cmu-argus-2/Avionics-BatteryBoard/MAX17205 Config/Page 4.png

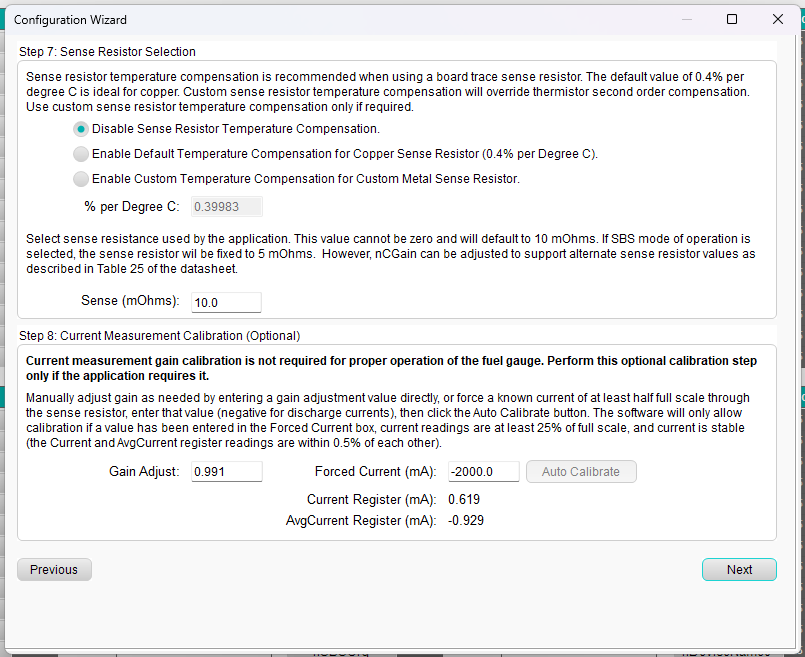
MAX17205 Config/Page 4.png
