cmu-argus-2/Avionics-BatteryBoard/MAX17205 Config/Page 5.png

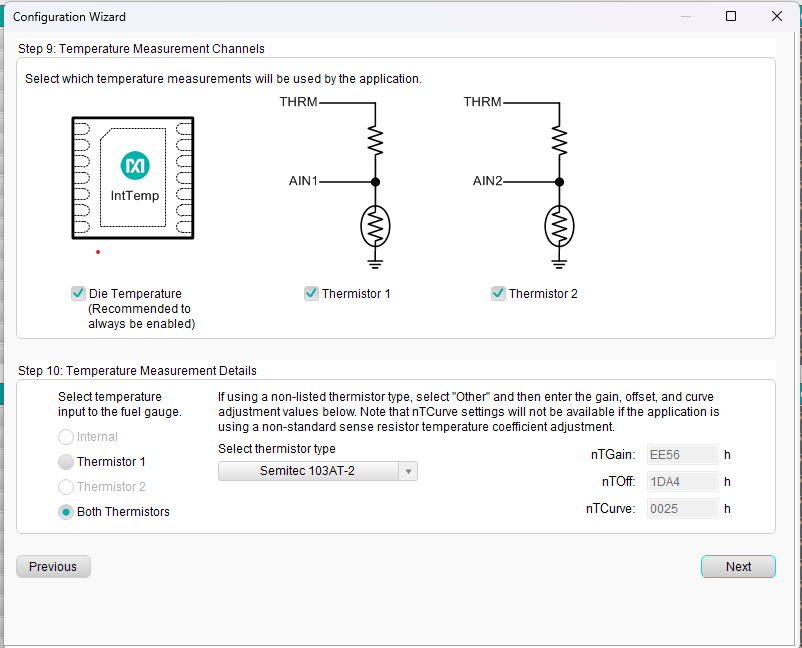
MAX17205 Config/Page 5.png
