cmu-argus-2/Avionics-BatteryBoard/Avionics-BatteryBoard.step

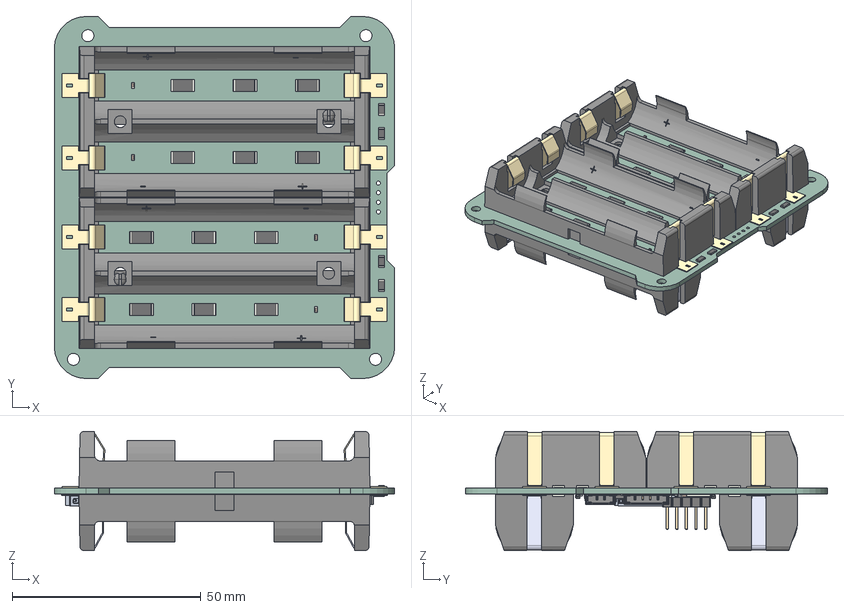
[picture p8: CAD file, 2026-04-14]
Avionics-BatteryBoard.step
90.2 x 95.9 x 31.5 mm
C_0603_1608Metric x 19
R_2512_6332Metric x 19
Fuse_1206_3216Metric x 11
SOT-23 x 3
TSSOP-8_4.4x3mm_P0.65mm x 2
SIRA99DP-T1-GE3 x 7
TLX9000_TPL_F x 3
SOT-363_SC-70-6 x 4
TSOT-23-6 x 2
R_0603_1608Metric x 46
C_0805_2012Metric
PinHeader_1x05_P2.54mm_Vertical_SMD_Pin1Left
LED_0603_1608Metric x 3
R_1206_3216Metric x 2
SOT-23-6 x 2
D_SMA
D_SOD-323 x 2
DFN-14-1EP_3x3mm_P0.4mm_EP1.78x2.35mm
Avionics-BatteryBoard_PCB
