cmu-argus-2/Avionics-BatteryBoard/(threads)

Thread 3 (2025-01-13):

Fix I2C diode pinout

NeilKhera, 2025-01-13:

Closed 2025-02-13.

Thread 8 (2025-01-13):

Batteryboard v3 Schematic Completed

NeilKhera, 2025-01-13:
Final Issue checkoff when the schematic is completed

Closed 2025-02-13.

Thread 9 (2025-01-13):

Batteryboard v3 Layout Completed

NeilKhera, 2025-01-13:
Final Issue checkoff when the layout is completed

Closed 2025-02-13.
