cmu-argus-2/Avionics-BatteryBoard/Avionics-BatteryBoard.kicad_pcb

## KiCad design Avionics-BatteryBoard.kicad_pcb (2026-07-21)

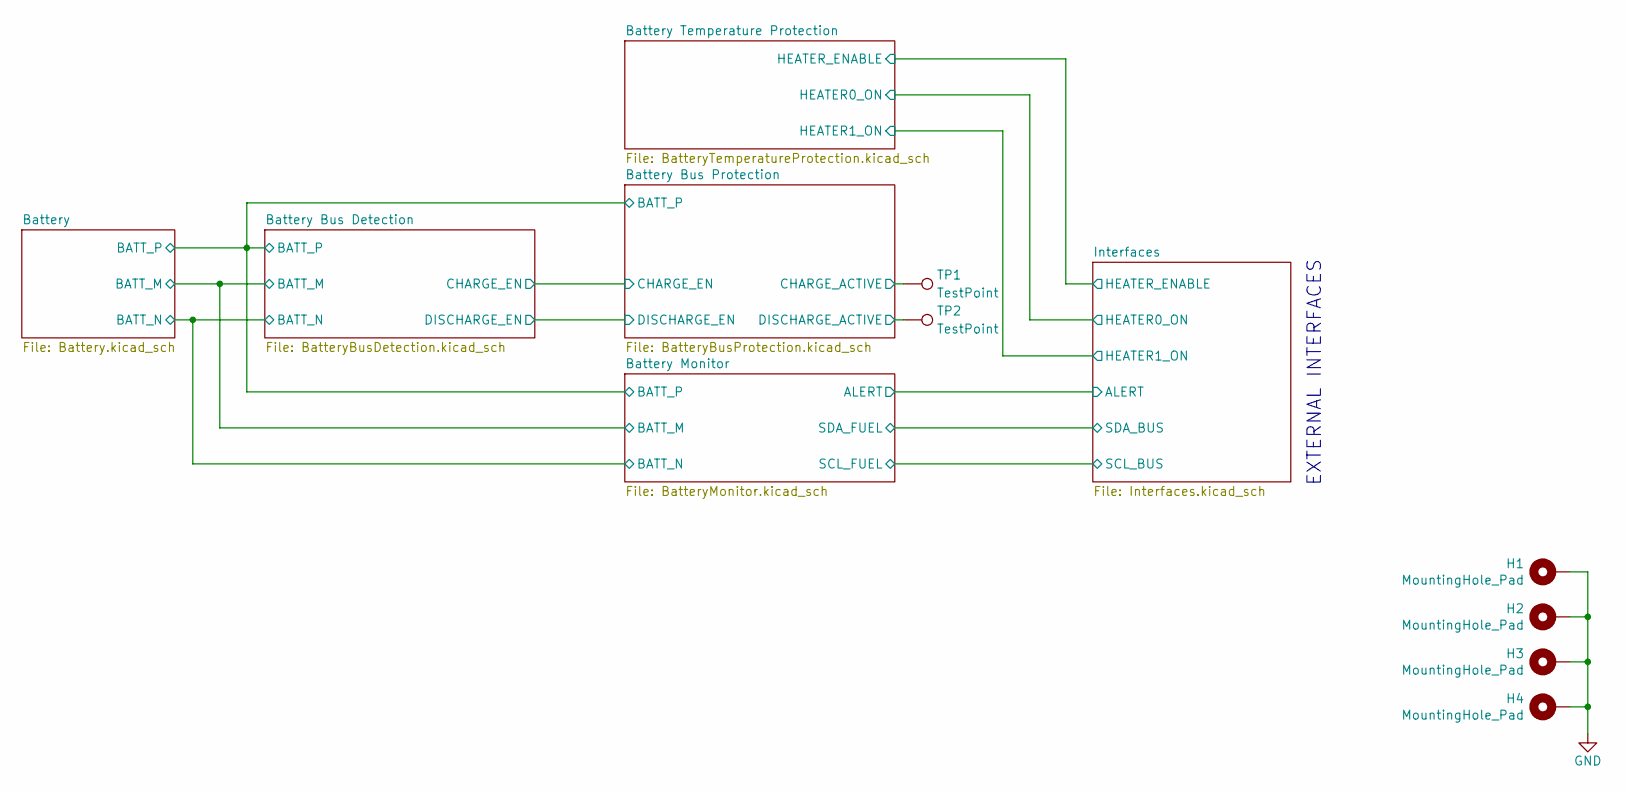
[picture p9: schematic Avionics-BatteryBoard.kicad_sch, Argus Batteryboard]

Parts:
H1, H2, H3, H4: MountingHole_Pad; MountingHole_3.2mm_M3_Pad_Via
TP1, TP2: TestPoint; TestPoint_Pad_D1.5mm

Connections:
/Battery Bus Protection/CHARGE_ACTIVE: TP1.1; also elsewhere on the board
/Battery Bus Protection/DISCHARGE_ACTIVE: TP2.1; also elsewhere on the board
GND: H1.1, H2.1, H3.1, H4.1; also elsewhere on the board

Notes on the sheet:
EXTERNAL INTERFACES

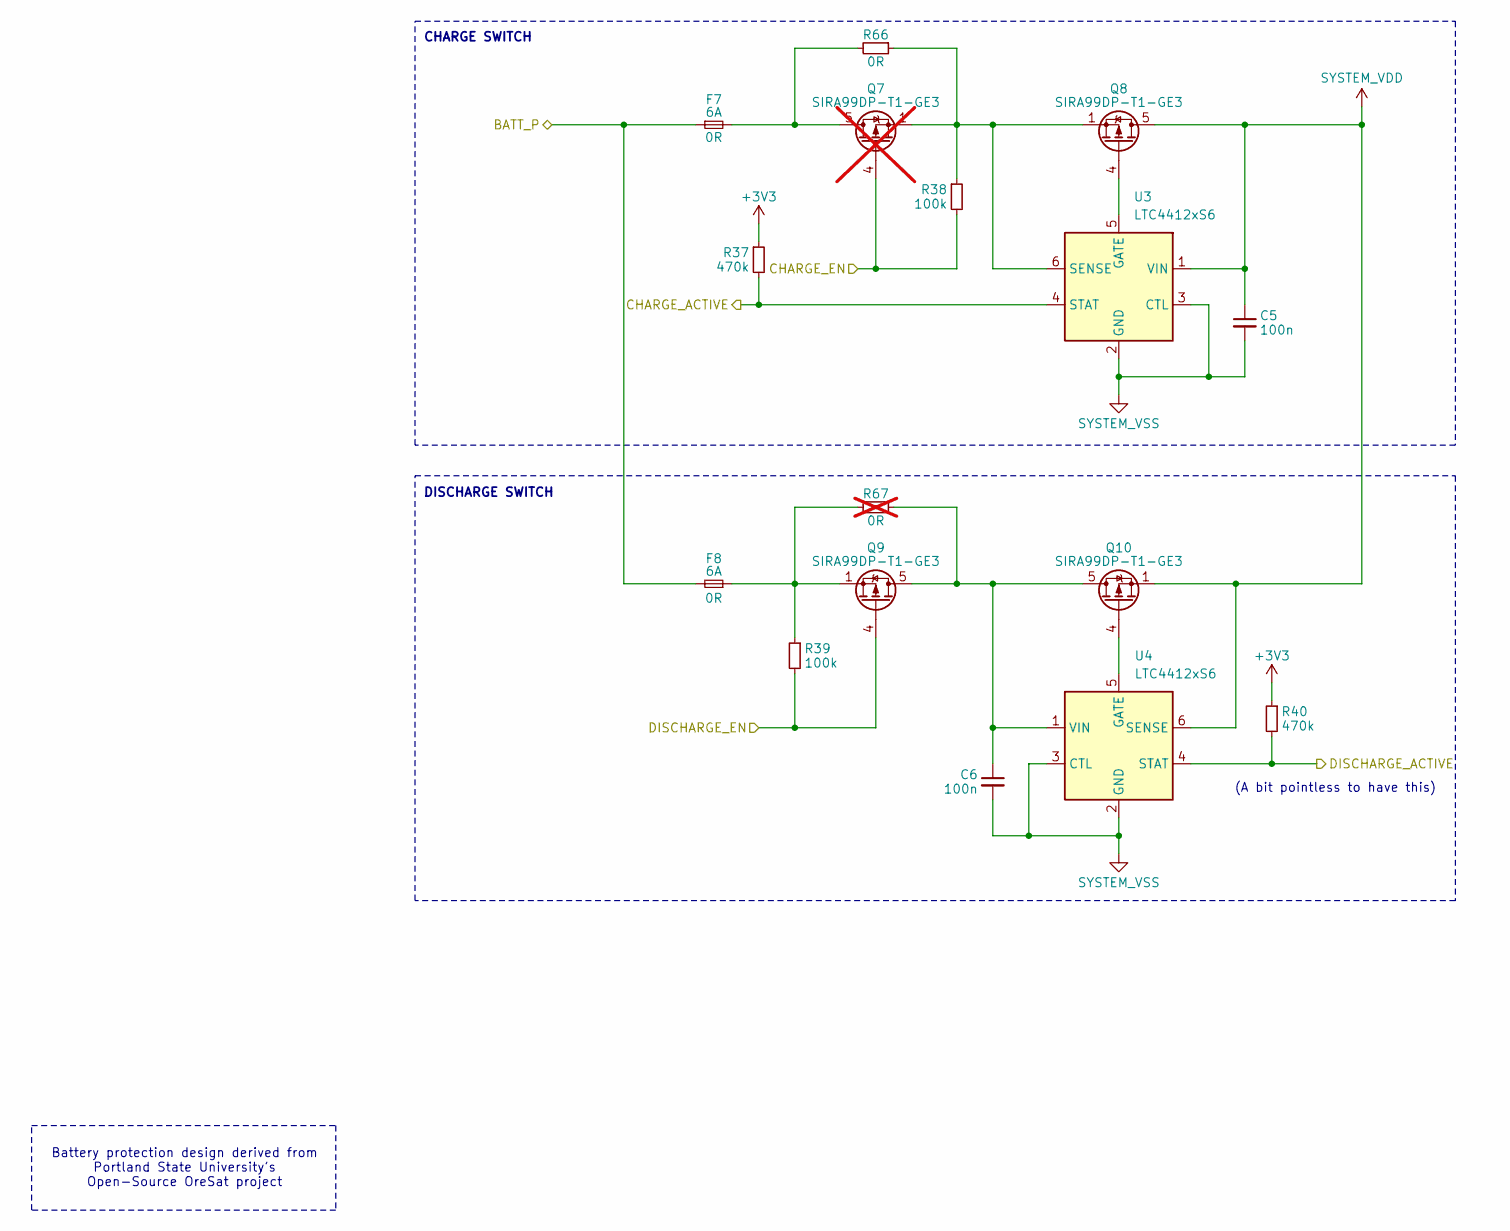
[picture p10: schematic BatteryBusProtection.kicad_sch, Argus Batteryboard]

Parts:
C5, C6: 100n; C_0603_1608Metric; MPN C307348
F7, F8: 6A; Fuse_1206_3216Metric; MPN C844862
Q7: SIRA99DP-T1-GE3; PowerPAK_SO-8_Single; MPN C3289459; not fitted
Q8, Q9, Q10: SIRA99DP-T1-GE3; PowerPAK_SO-8_Single; MPN C3289459
R37, R40: 470k; R_0603_1608Metric; MPN C138280
R38, R39: 100k; R_0603_1608Metric; MPN C237792
R66: 0R; R_1206_3216Metric; MPN C237792
R67: 0R; R_1206_3216Metric; MPN C237792; not fitted
U3, U4: LTC4412xS6; TSOT-23-6

Connections:
+3V3: R37.1, R40.1; also elsewhere on the board
/Battery Bus Detection/BATT_P: F7.1, F8.2; also elsewhere on the board
/Battery Bus Detection/CHARGE_EN: Q7.4 (G), R38.2; also elsewhere on the board
/Battery Bus Detection/DISCHARGE_EN: Q9.4 (G), R39.2; also elsewhere on the board
/Battery Bus Protection/CHARGE_ACTIVE: R37.2, U3.4 (STAT); also elsewhere on the board
/Battery Bus Protection/DISCHARGE_ACTIVE: R40.2, U4.4 (STAT); also elsewhere on the board
unnamed: F8.1, Q9.1 (S), Q9.2 (S), Q9.3 (S), R39.1, R67.2
unnamed: F7.2, Q7.5 (D), R66.2
unnamed: Q8.4 (G), U3.5 (GATE)
unnamed: C6.1, Q9.5 (D), Q10.5 (D), R67.1, U4.1 (VIN)
unnamed: Q10.4 (G), U4.5 (GATE)
unnamed: Q7.1 (S), Q7.2 (S), Q7.3 (S), Q8.1 (S), Q8.2 (S), Q8.3 (S), R38.1, R66.1, U3.6 (SENSE)
SYSTEM_VDD: C5.1, Q8.5 (D), Q10.1 (S), Q10.2 (S), Q10.3 (S), U3.1 (VIN), U4.6 (SENSE); also elsewhere on the board
SYSTEM_VSS: C5.2, C6.2, U3.2 (GND), U3.3 (CTL), U4.2 (GND), U4.3 (CTL); also elsewhere on the board

Notes on the sheet:
CHARGE SWITCH
(A bit pointless to have this)
Battery protection design derived from Portland State University's Open-Source OreSat project
DISCHARGE SWITCH

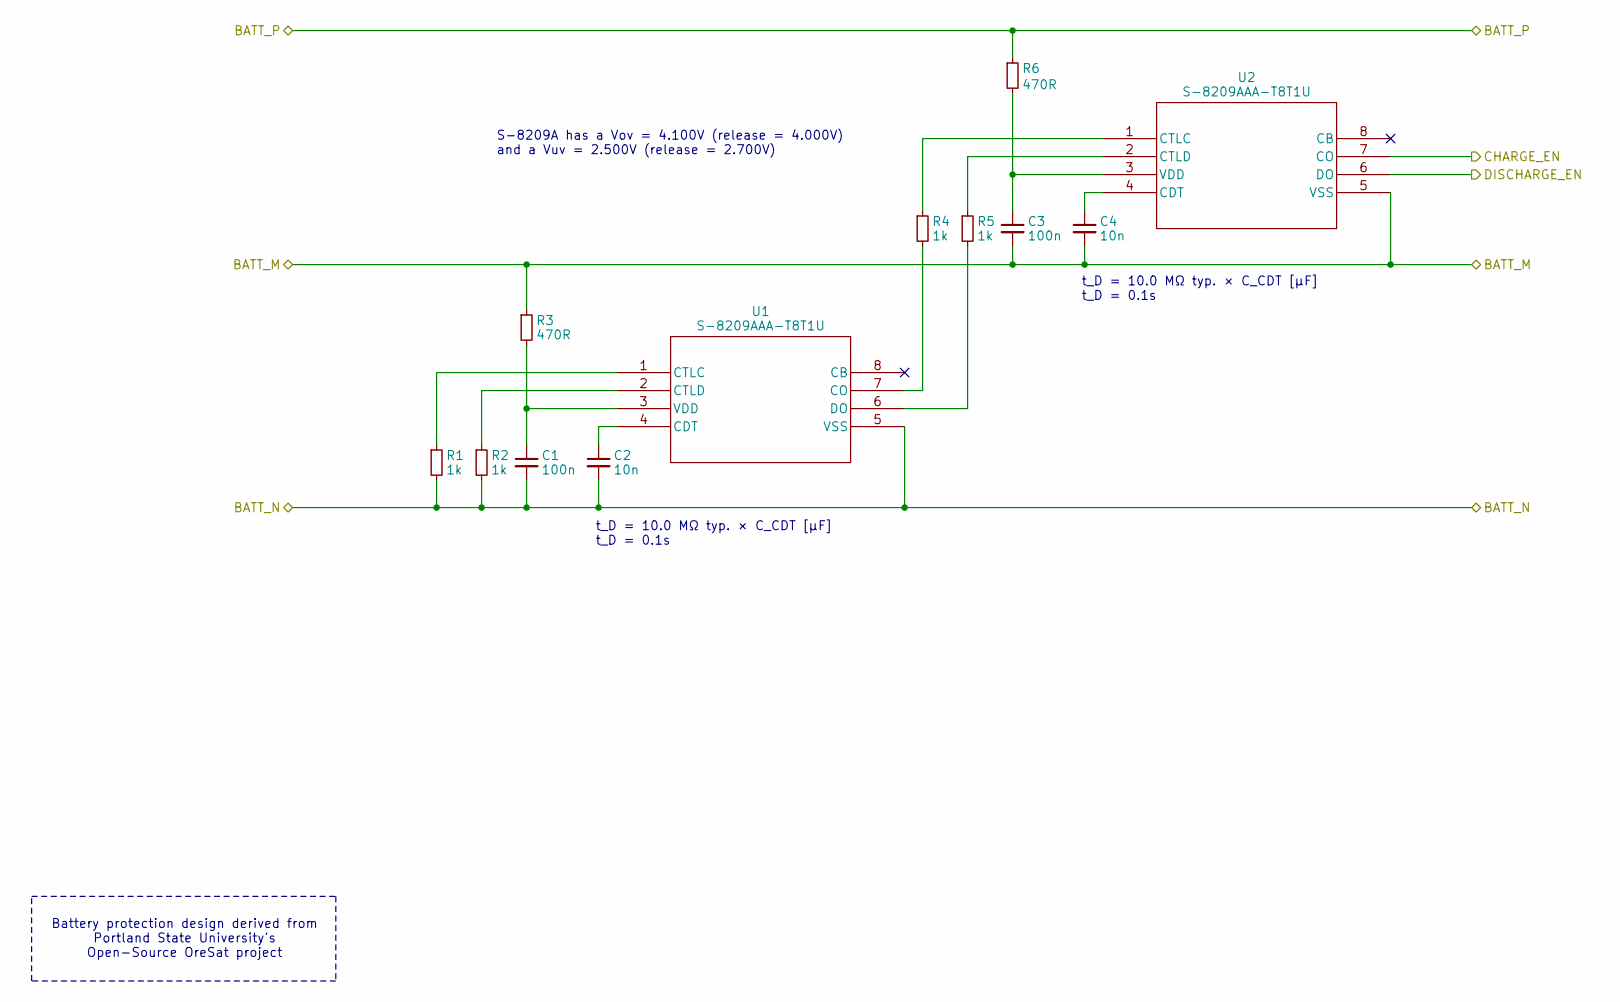
[picture p11: schematic BatteryBusDetection.kicad_sch, Argus Batteryboard]

Parts:
C1, C3: 100n; C_0603_1608Metric; MPN C307348
C2, C4: 10n; C_0603_1608Metric; MPN C161232
R1, R2, R4, R5: 1k; R_0603_1608Metric; MPN C2484712
R3, R6: 470R; R_0603_1608Metric; MPN C844564
U1, U2: S-8209AAA-T8T1U; TSSOP8-E-PKG_FT008-A-P-SD-1.2_ABL

Connections:
/Battery Bus Detection/BATT_M: C3.2, C4.2, R3.1, U2.5 (VSS); also elsewhere on the board
/Battery Bus Detection/BATT_N: C1.2, C2.2, R1.2, R2.2, U1.5 (VSS); also elsewhere on the board
/Battery Bus Detection/BATT_P: R6.1; also elsewhere on the board
/Battery Bus Detection/CHARGE_EN: U2.7 (CO); also elsewhere on the board
/Battery Bus Detection/DISCHARGE_EN: U2.6 (DO); also elsewhere on the board
unnamed: C2.1, U1.4 (CDT)
unnamed: R4.2, U1.7 (CO)
unnamed: R1.1, U1.1 (CTLC)
unnamed: R2.1, U1.2 (CTLD)
unnamed: R5.2, U1.6 (DO)
unnamed: C1.1, R3.2, U1.3 (VDD)
unnamed: C4.1, U2.4 (CDT)
unnamed: R4.1, U2.1 (CTLC)
unnamed: R5.1, U2.2 (CTLD)
unnamed: C3.1, R6.2, U2.3 (VDD)

Notes on the sheet:
S-8209A has a Vov = 4.100V (release = 4.000V) and a Vuv = 2.500V (release = 2.700V)
t_D = 10.0 MΩ typ. × C_CDT [μF] t_D = 0.1s
Battery protection design derived from Portland State University's Open-Source OreSat project

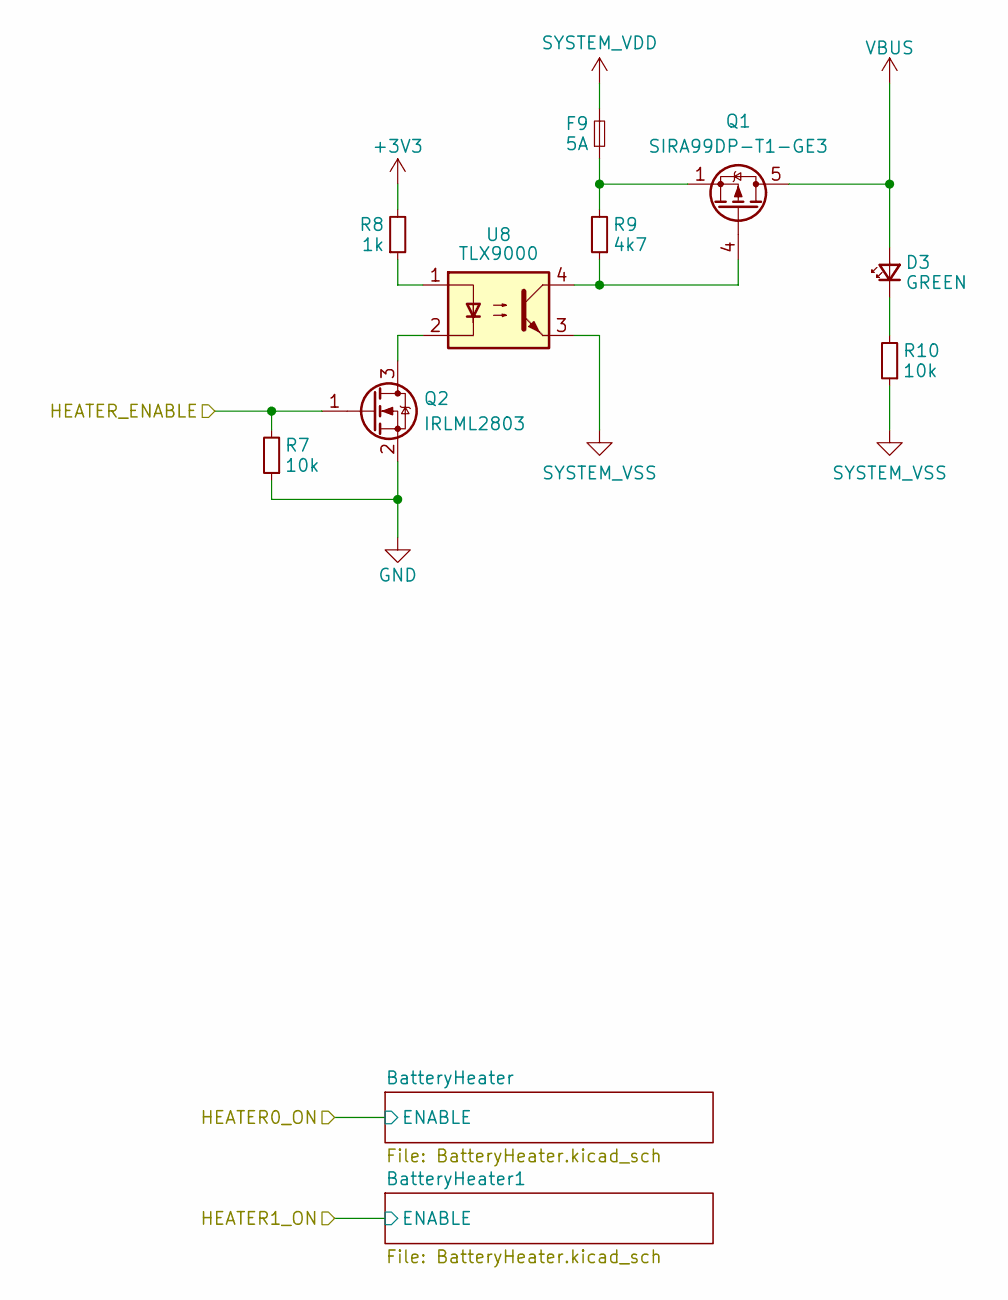
[picture p12: schematic BatteryTemperatureProtection.kicad_sch, Argus Batteryboard]

Parts:
D3: GREEN; LED_0603_1608Metric; MPN C2909774
F9: 5A; Fuse_1206_3216Metric
Q1: SIRA99DP-T1-GE3; PowerPAK_SO-8_Single; MPN C3289459
Q2: IRLML2803; SOT-23; MPN C2590
R7, R10: 10k; R_0603_1608Metric; MPN C2479067
R8: 1k; R_0603_1608Metric; MPN C2479067
R9: 4k7; R_0603_1608Metric; MPN C2479067
U8: TLX9000; SOIC-4_4.55x2.6mm_P1.27mm

Connections:
+3V3: R8.2; also elsewhere on the board
/Interfaces/HEATER_ENABLE: Q2.1 (G), R7.2; also elsewhere on the board
GND: Q2.2 (S), R7.1; also elsewhere on the board
unnamed: D3.1 (K), R10.2
unnamed: F9.1, Q1.1 (S), Q1.2 (S), Q1.3 (S), R9.2
unnamed: Q1.4 (G), R9.1, U8.4
unnamed: Q2.3 (D), U8.2
unnamed: R8.1, U8.1
SYSTEM_VDD: F9.2; also elsewhere on the board
SYSTEM_VSS: R10.1, U8.3; also elsewhere on the board
VBUS: D3.2 (A), Q1.5 (D); also elsewhere on the board

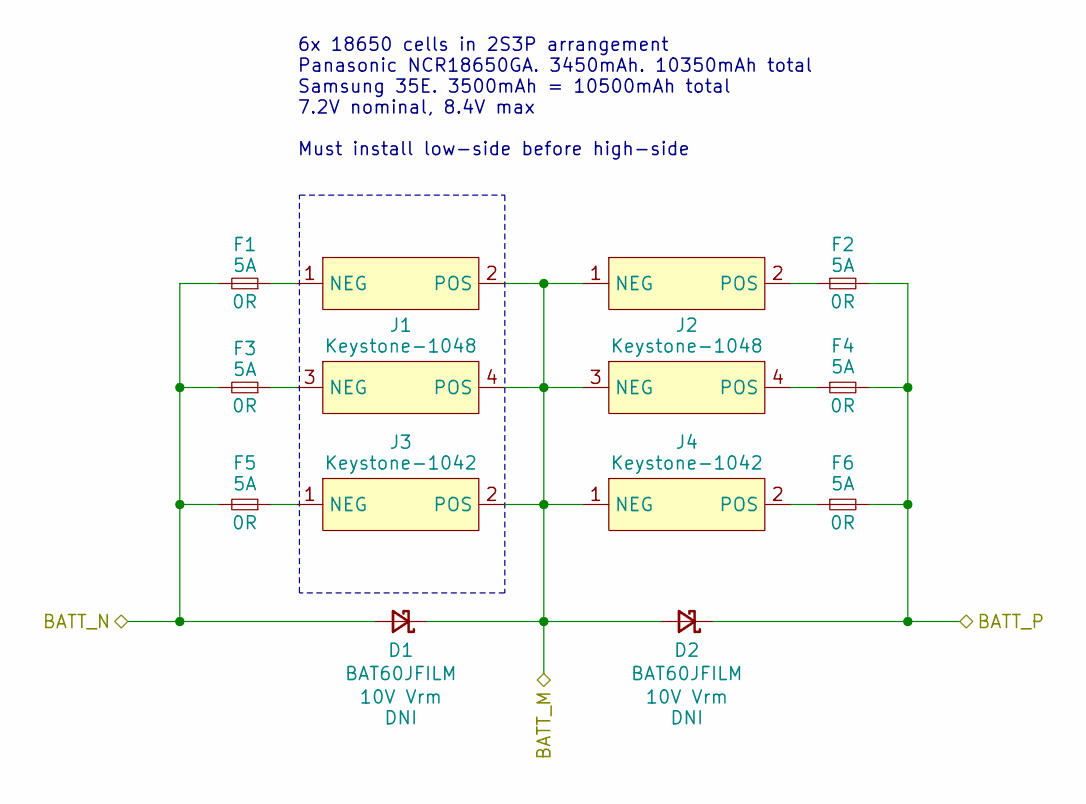
[picture p13: schematic Battery.kicad_sch, Argus Batteryboard]

Parts:
D1, D2: BAT60JFILM; D_SOD-323_HandSoldering
F1, F2, F3, F4, F5, F6: 5A; Fuse_1206_3216Metric; MPN C844862
J1, J2: Keystone-1048; BAT_1048
J3, J4: Keystone-1042; Keystone_1042

Connections:
/Battery Bus Detection/BATT_M: D1.1 (K), D2.2 (A), J1.2 (POS), J1.4 (POS), J2.1 (NEG), J2.3 (NEG), J3.2 (POS), J4.1 (NEG); also elsewhere on the board
/Battery Bus Detection/BATT_N: D1.2 (A), F1.2, F3.2, F5.2; also elsewhere on the board
/Battery Bus Detection/BATT_P: D2.1 (K), F2.2, F4.2, F6.2; also elsewhere on the board
unnamed: F1.1, J1.1 (NEG)
unnamed: F2.1, J2.2 (POS)
unnamed: F3.1, J1.3 (NEG)
unnamed: F4.1, J2.4 (POS)
unnamed: F5.1, J3.1 (NEG)
unnamed: F6.1, J4.2 (POS)

Notes on the sheet:
6x 18650 cells in 2S3P arrangement Panasonic NCR18650GA. 3450mAh. 10350mAh total Samsung 35E. 3500mAh = 10500mAh total 7.2V nominal, 8.4V max
Must install low-side before high-side

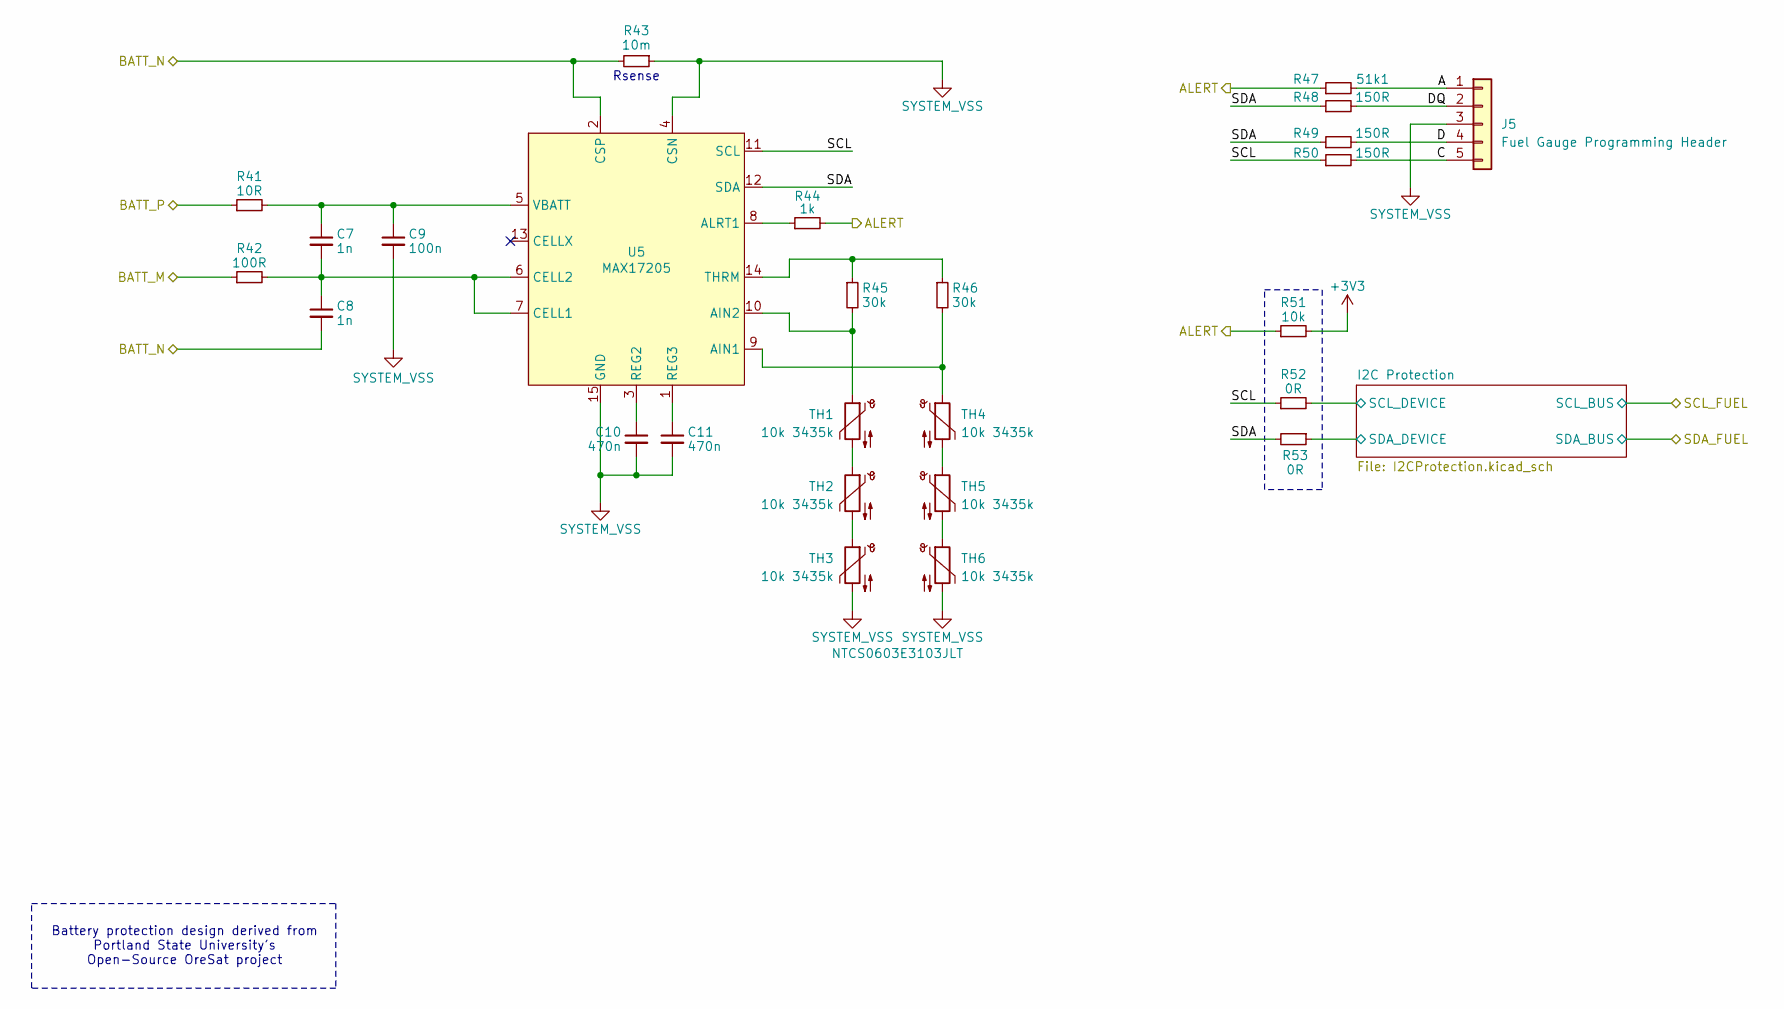
[picture p14: schematic BatteryMonitor.kicad_sch, Argus Batteryboard]

Parts:
C7, C8: 1n; C_0603_1608Metric; MPN C161231
C9: 100n; C_0603_1608Metric; MPN C307348
C10, C11: 470n; C_0603_1608Metric; MPN C472773
J5: Fuel Gauge Programming Header; PinHeader_1x05_P2.54mm_Vertical_SMD_Pin1Left
R41: 10R; R_0603_1608Metric; MPN C3029194
R42: 100R; R_0603_1608Metric; MPN C844917
R43: 10m; R_2512_6332Metric; MPN C840621
R44: 1k; R_0603_1608Metric; MPN C2484712
R45, R46: 30k; R_0603_1608Metric; MPN C844774
R47: 51k1; R_0603_1608Metric; MPN C844575
R48, R49, R50: 150R; R_0603_1608Metric; MPN C844741
R51: 10k; R_0603_1608Metric; MPN C2479067
R52, R53: 0R; R_0603_1608Metric; MPN C844915
TH1, TH2, TH3, TH4, TH5, TH6: 10k 3435k; C_0603_1608Metric
U5: MAX17205; TDFN-14-1EP_3x3mm_P0.4mm_EP1.78x2.35mm; MPN C401140

Connections:
+3V3: R51.2; also elsewhere on the board
/Battery Bus Detection/BATT_M: R42.1; also elsewhere on the board
/Battery Bus Detection/BATT_N: C8.2, R43.2, U5.2 (CSP); also elsewhere on the board
/Battery Bus Detection/BATT_P: R41.1; also elsewhere on the board
/Battery Monitor/A: J5.1, R47.2
/Battery Monitor/C: J5.5, R50.2
/Battery Monitor/D: J5.4, R49.2
/Battery Monitor/DQ: J5.2, R48.2
/Battery Monitor/I2C Protection/SCL_DEVICE: R52.2; also elsewhere on the board
/Battery Monitor/I2C Protection/SDA_DEVICE: R53.1; also elsewhere on the board
/Battery Monitor/SCL: R50.1, R52.1, U5.11 (SCL)
/Battery Monitor/SDA: R48.1, R49.1, R53.2, U5.12 (SDA)
/Interfaces/ALERT: R44.2, R47.1, R51.1; also elsewhere on the board
unnamed: TH1.2, TH2.1
unnamed: TH2.2, TH3.1
unnamed: TH4.2, TH5.1
unnamed: TH5.2, TH6.1
unnamed: R46.2, TH4.1, U5.9 (AIN1)
unnamed: R45.2, TH1.1, U5.10 (AIN2)
unnamed: R44.1, U5.8 (ALRT1)
unnamed: C7.2, C8.1, R42.2, U5.6 (CELL2), U5.7 (CELL1)
unnamed: C10.1, U5.3 (REG2)
unnamed: C11.1, U5.1 (REG3)
unnamed: R45.1, R46.1, U5.14 (THRM)
unnamed: C7.1, C9.1, R41.2, U5.5 (VBATT)
SYSTEM_VSS: C9.2, C10.2, C11.2, J5.3, R43.1, TH3.2, TH6.2, U5.4 (CSN), U5.15 (GND); also elsewhere on the board

Notes on the sheet:
Rsense
Battery protection design derived from Portland State University's Open-Source OreSat project

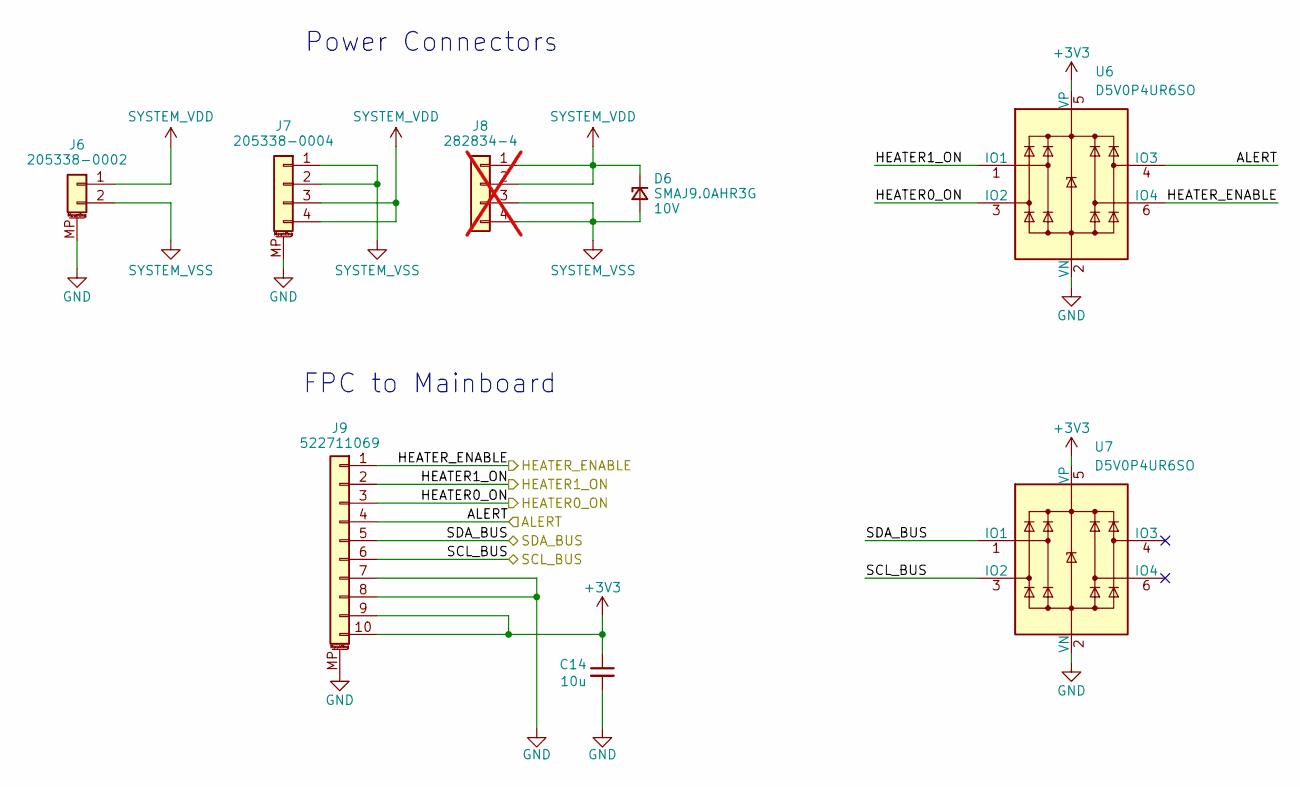
[picture p15: schematic Interfaces.kicad_sch, Argus Batteryboard]

Parts:
C14: 10u; C_0805_2012Metric; MPN C386084
D6: SMAJ9.0AHR3G; D_SMA; Part 10V
J6: 205338-0002; Molex_Pico-Lock_205338-0002_1x02-1MP_P2.00mm_Horizontal; MPN C17575002
J7: 205338-0004; Molex_Pico-Lock_205338-0004_1x04-1MP_P2.00mm_Horizontal; MPN C916325
J8: 282834-4; TerminalBlock_TE_282834-4_1x04_P2.54mm_Horizontal; not fitted
J9: 522711069; CON_522711069_MOL; MPN C588180
U6, U7: D5V0P4UR6SO; SOT-23-6; MPN C531179

Connections:
+3V3: C14.1, J9.9, J9.10, U6.5 (VP), U7.5 (VP); also elsewhere on the board
/Interfaces/ALERT: J9.4, U6.4 (IO3); also elsewhere on the board
/Interfaces/HEATER0_ON: J9.3, U6.3 (IO2); also elsewhere on the board
/Interfaces/HEATER1_ON: J9.2, U6.1 (IO1); also elsewhere on the board
/Interfaces/HEATER_ENABLE: J9.1, U6.6 (IO4); also elsewhere on the board
/Interfaces/SCL_BUS: J9.6, U7.3 (IO2); also elsewhere on the board
/Interfaces/SDA_BUS: J9.5, U7.1 (IO1); also elsewhere on the board
GND: C14.2, J6.MP (MountPin), J7.MP (MountPin), J9.7, J9.8, J9.MP (MountPin), U6.2 (VN), U7.2 (VN); also elsewhere on the board
SYSTEM_VDD: D6.1 (K), J6.1, J7.3, J7.4, J8.1, J8.2; also elsewhere on the board
SYSTEM_VSS: D6.2 (A), J6.2, J7.1, J7.2, J8.3, J8.4; also elsewhere on the board

Notes on the sheet:
FPC to Mainboard
Power Connectors

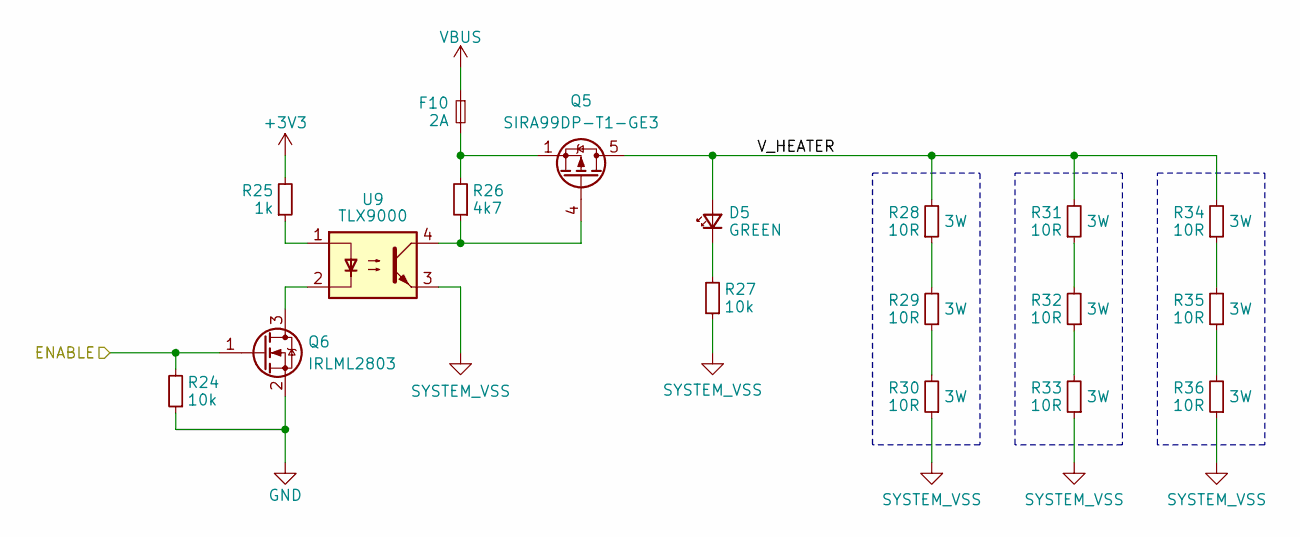
[picture p16: schematic BatteryHeater.kicad_sch, Argus Batteryboard]

Parts:
D5: GREEN; LED_0603_1608Metric; MPN C2909774
F10: 2A; Fuse_1206_3216Metric
Q5: SIRA99DP-T1-GE3; PowerPAK_SO-8_Single; MPN C3289459
Q6: IRLML2803; SOT-23; MPN C2590
R24, R27: 10k; R_0603_1608Metric; MPN C2479067
R25: 1k; R_0603_1608Metric; MPN C2479067
R26: 4k7; R_0603_1608Metric; MPN C2479067
R28, R29, R30, R31, R32, R33, R34, R35, R36: 10R; R_2512_6332Metric
U9: TLX9000; SOIC-4_4.55x2.6mm_P1.27mm

Connections:
+3V3: R25.2; also elsewhere on the board
/Battery Temperature Protection/BatteryHeater1/V_HEATER: D5.2 (A), Q5.5 (D), R28.2, R31.2, R34.2
/Interfaces/HEATER1_ON: Q6.1 (G), R24.2; also elsewhere on the board
GND: Q6.2 (S), R24.1; also elsewhere on the board
unnamed: D5.1 (K), R27.2
unnamed: F10.2, Q5.1 (S), Q5.2 (S), Q5.3 (S), R26.2
unnamed: Q5.4 (G), R26.1, U9.4
unnamed: Q6.3 (D), U9.2
unnamed: R25.1, U9.1
unnamed: R28.1, R29.2
unnamed: R29.1, R30.2
unnamed: R31.1, R32.2
unnamed: R32.1, R33.2
unnamed: R34.1, R35.2
unnamed: R35.1, R36.2
SYSTEM_VSS: R27.1, R30.1, R33.1, R36.1, U9.3; also elsewhere on the board
VBUS: F10.1; also elsewhere on the board

Parts of its further copies:
D4: GREEN; LED_0603_1608Metric; MPN C2909774
F11: 2A; Fuse_1206_3216Metric
Q3: SIRA99DP-T1-GE3; PowerPAK_SO-8_Single; MPN C3289459
Q4: IRLML2803; SOT-23; MPN C2590
R11, R14: 10k; R_0603_1608Metric; MPN C2479067
R12: 1k; R_0603_1608Metric; MPN C2479067
R13: 4k7; R_0603_1608Metric; MPN C2479067
R15, R16, R17, R18, R19, R20, R21, R22, R23: 10R; R_2512_6332Metric
U10: TLX9000; SOIC-4_4.55x2.6mm_P1.27mm

Connections of its further copies:
+3V3: R12.2; also elsewhere on the board
/Battery Temperature Protection/BatteryHeater/V_HEATER: D4.2 (A), Q3.5 (D), R15.2, R18.2, R21.2
/Interfaces/HEATER0_ON: Q4.1 (G), R11.2; also elsewhere on the board
GND: Q4.2 (S), R11.1; also elsewhere on the board
unnamed: D4.1 (K), R14.2
unnamed: F11.2, Q3.1 (S), Q3.2 (S), Q3.3 (S), R13.2
unnamed: Q3.4 (G), R13.1, U10.4
unnamed: Q4.3 (D), U10.2
unnamed: R12.1, U10.1
unnamed: R15.1, R16.2
unnamed: R16.1, R17.2
unnamed: R18.1, R19.2
unnamed: R19.1, R20.2
unnamed: R21.1, R22.2
unnamed: R22.1, R23.2
SYSTEM_VSS: R14.1, R17.1, R20.1, R23.1, U10.3; also elsewhere on the board
VBUS: F11.1; also elsewhere on the board

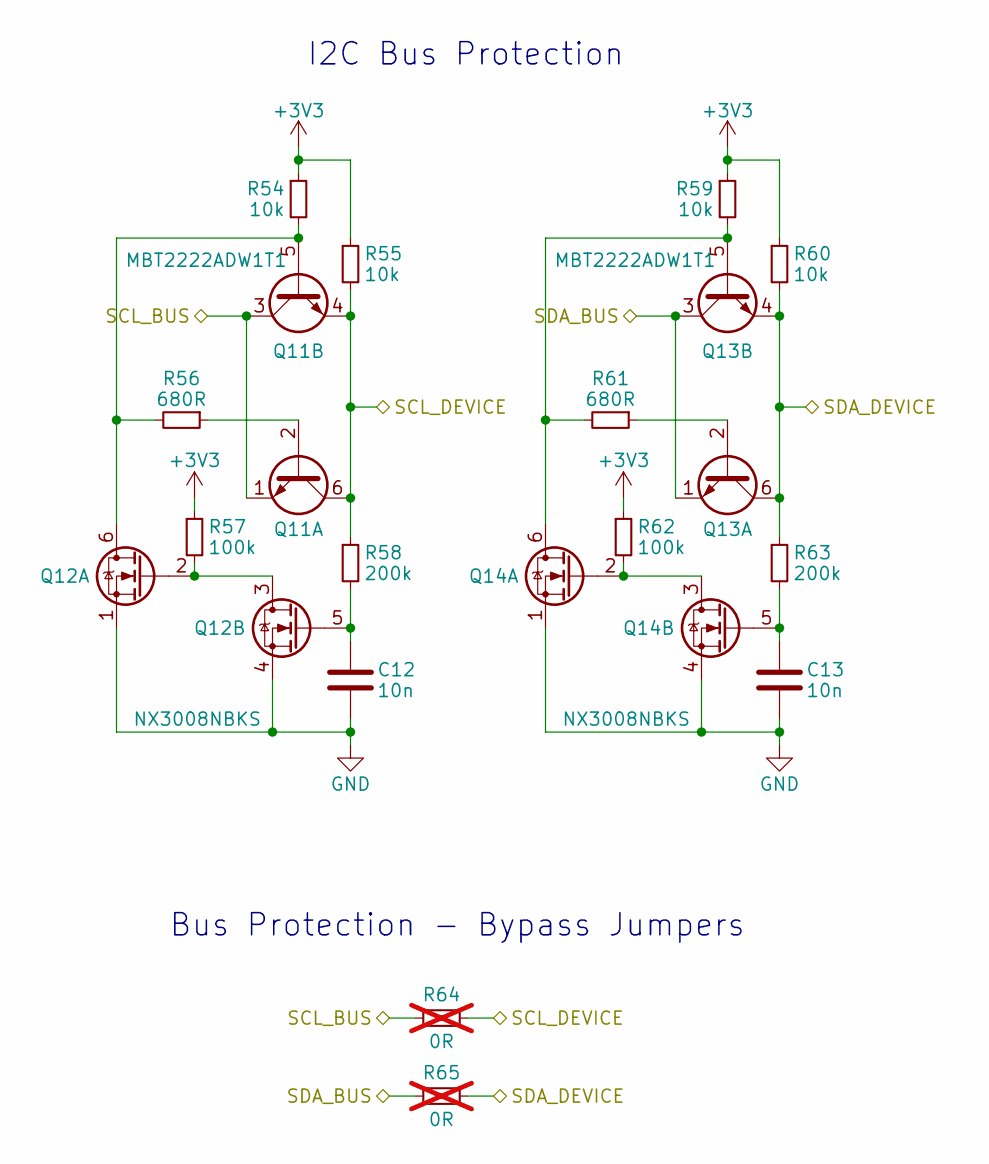
[picture p17: schematic I2CProtection.kicad_sch, Argus Batteryboard]

Parts:
C12, C13: 10n; C_0603_1608Metric; MPN C161232
Q11, Q13: MBT2222ADW1T1; SOT-363_SC-70-6; Manufacturer_Part_Number MBT2222ADW1T1G
Q12, Q14: NX3008NBKS; SOT-363_SC-70-6; MPN C3280240
R54, R55, R59, R60: 10k; R_0603_1608Metric; MPN C2479067
R56, R61: 680R; R_0603_1608Metric; MPN C844802
R57, R62: 100k; R_0603_1608Metric; MPN C237792
R58, R63: 200k; R_0603_1608Metric; MPN C118142
R64, R65: 0R; R_0603_1608Metric; not fitted

Connections:
+3V3: R54.1, R55.1, R57.1, R59.1, R60.1, R62.1; also elsewhere on the board
/Battery Monitor/I2C Protection/SCL_DEVICE: Q11.4 (E2), Q11.6 (C1), R55.2, R58.1, R64.1; also elsewhere on the board
/Battery Monitor/I2C Protection/SDA_DEVICE: Q13.4 (E2), Q13.6 (C1), R60.2, R63.1, R65.1; also elsewhere on the board
/Interfaces/SCL_BUS: Q11.1 (E1), Q11.3 (C2), R64.2; also elsewhere on the board
/Interfaces/SDA_BUS: Q13.1 (E1), Q13.3 (C2), R65.2; also elsewhere on the board
GND: C12.2, C13.2, Q12.1 (S), Q12.4 (S), Q14.1 (S), Q14.4 (S); also elsewhere on the board
unnamed: Q11.2 (B1), R56.1
unnamed: Q11.5 (B2), Q12.6 (D), R54.2, R56.2
unnamed: Q12.2 (G), Q12.3 (D), R57.2
unnamed: C12.1, Q12.5 (G), R58.2
unnamed: Q13.2 (B1), R61.1
unnamed: Q13.5 (B2), Q14.6 (D), R59.2, R61.2
unnamed: Q14.2 (G), Q14.3 (D), R62.2
unnamed: C13.1, Q14.5 (G), R63.2

Notes on the sheet:
I2C Bus Protection
Bus Protection - Bypass Jumpers

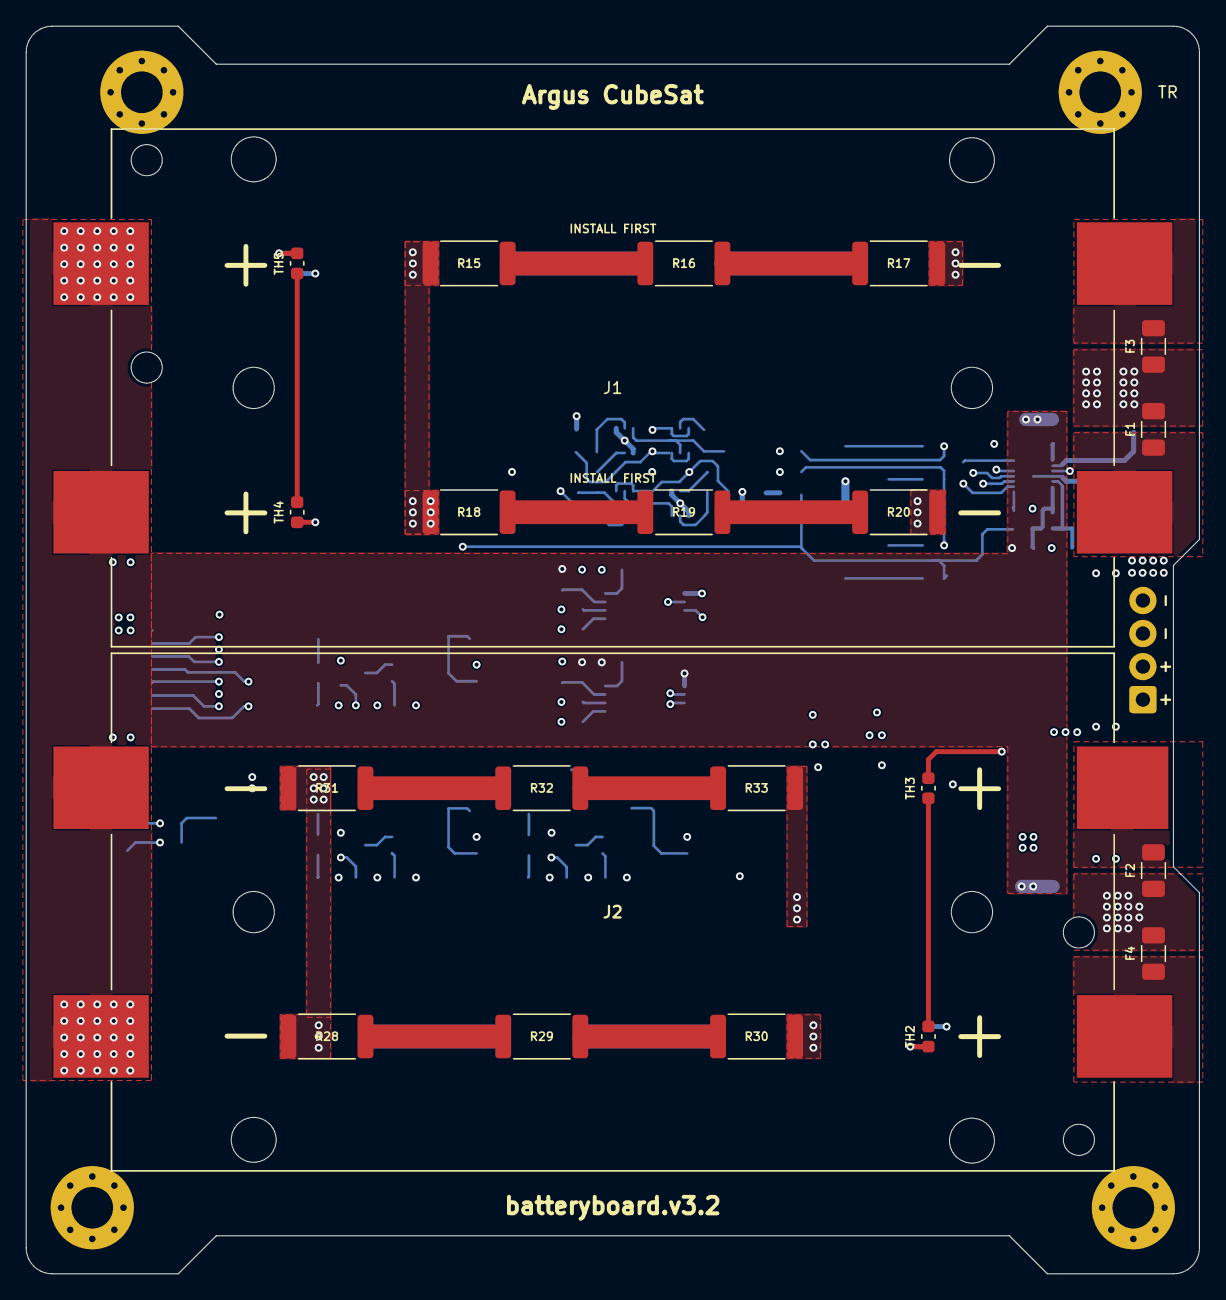
[picture p18: board Avionics-BatteryBoard.kicad_pcb from above]

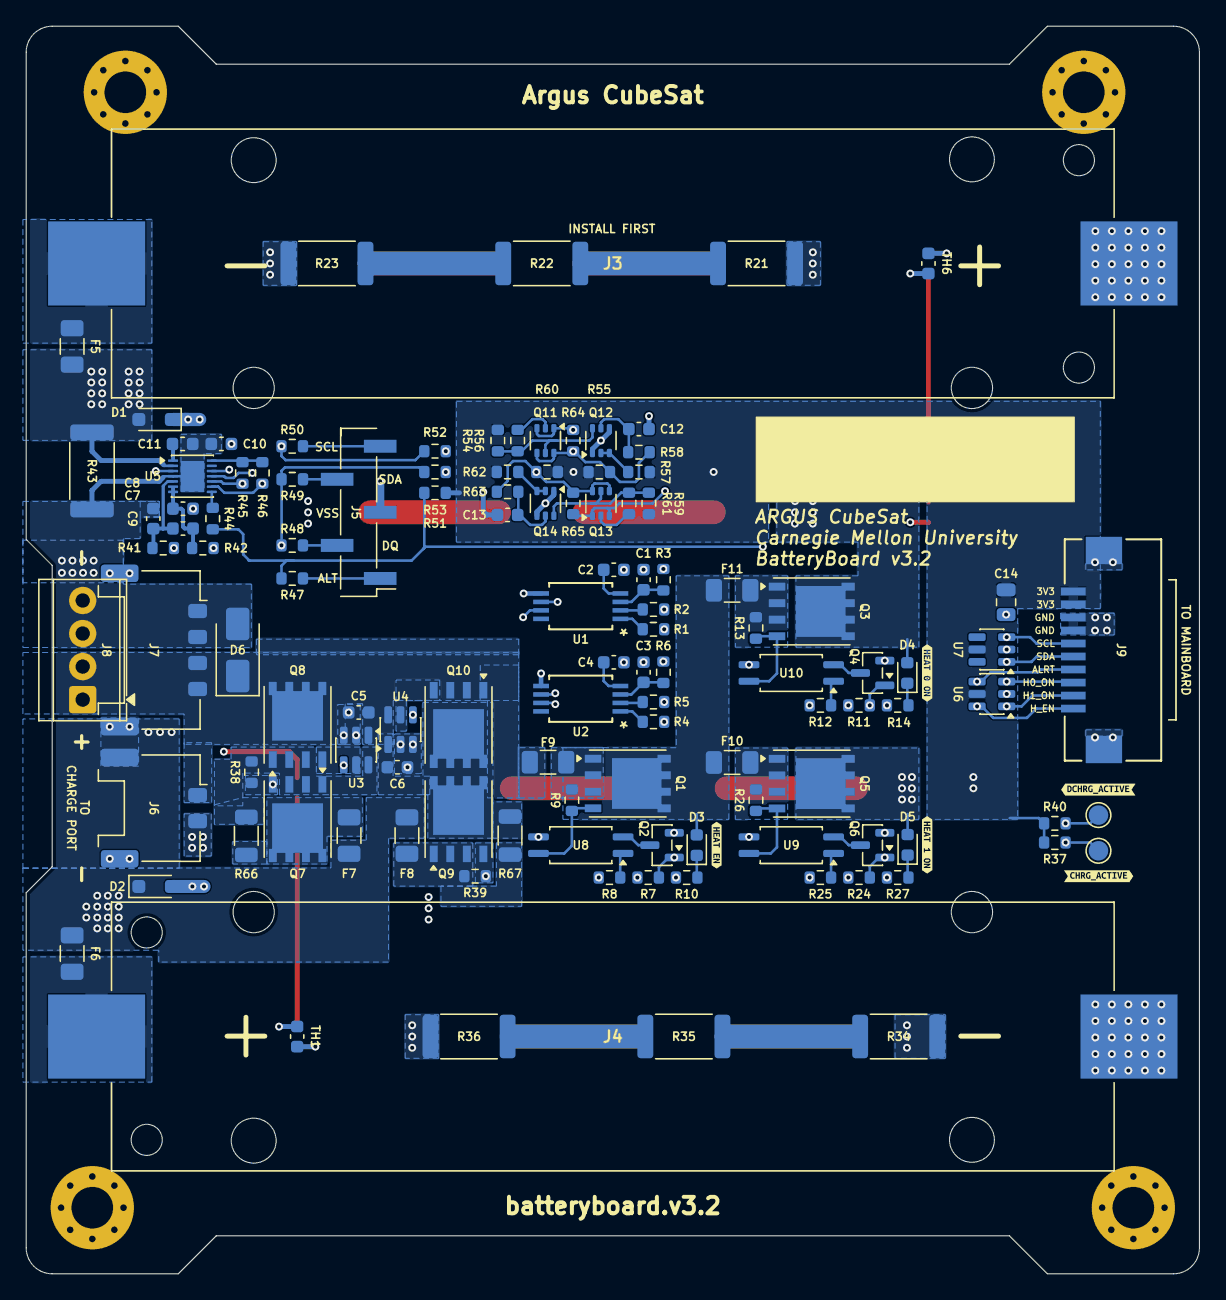
[picture p19: board Avionics-BatteryBoard.kicad_pcb from below]

Board: 4 copper layers, 90.2 x 95.9 mm, 148 parts (122 on the bottom side), 97 nets.

Other parts of the board:
kibuzzard-69DDC83B: G***; kibuzzard-69DDC83B
kibuzzard-6786F69C: G***; kibuzzard-6786F69C
kibuzzard-6780351B: G***; kibuzzard-6780351B
kibuzzard-67803442: G***; kibuzzard-67803442
kibuzzard-67803551: G***; kibuzzard-67803551
