cmu-argus-2/Avionics-BatteryBoard/(commit log)

2024-09-17 Added KiCad libs
2024-09-18 Initial project setup
    [BatteryBoard.kicad_pcb, BatteryBoard.kicad_sch]
2024-09-21 First pass at battery board schematics
    [BatteryBoard.kicad_sch, BatteryBusDetection.kicad_sch, BatteryBusProtection.kicad_sch, BatteryMonitor.kicad_sch, BatteryTemperatureProtection.kicad_sch, I2CProtection.kicad_sch, IOExpander.kicad_sch]
2024-09-29 Refactored schematics and silkscreen
    [Battery.kicad_sch, BatteryBoard.kicad_pcb, BatteryBoard.kicad_sch, BatteryBusDetection.kicad_sch, BatteryBusProtection.kicad_sch, BatteryMonitor.kicad_sch, BatteryTemperatureProtection.kicad_sch, I2CProtection.kicad_sch]
2024-09-29 Updated footprint
    [BatteryBoard.kicad_pcb]
2024-09-29 added thermal relief connection for fpc connector
    [BatteryBoard.kicad_pcb]
2024-10-02 Changes for lib refactor
    [Battery.kicad_sch, BatteryBoard.kicad_pcb, BatteryBusDetection.kicad_sch, BatteryBusProtection.kicad_sch, BatteryMonitor.kicad_sch, Interfaces.kicad_sch]
2024-10-04 Fixes from feedback
    [BatteryBoard.kicad_pcb, BatteryBoard.kicad_sch, BatteryBusDetection.kicad_sch, BatteryBusProtection.kicad_sch, I2CProtection.kicad_sch, Interfaces.kicad_sch]
2024-10-05 Added more silkscreen for mainboard connector
    [BatteryBoard.kicad_pcb]
2024-10-06 Updated silkscreen
    [BatteryBoard.kicad_pcb]
2024-10-07 Minor DRC Fixes, exported BOM and STEP model
    [BatteryBoard.kicad_pcb]
2024-11-19 Updated version to v2.1
    [BatteryBoard.kicad_pcb, BatteryBoard.kicad_sch]
2024-11-19 Removed submodule KiCad-Libraries
2024-11-19 Re-add Kicad-Libraries
2024-12-20 v2.1 (v3?) Partial Updates
    [Battery.kicad_sch, BatteryBoard.kicad_pcb, BatteryBoard.kicad_sch, BatteryBusDetection.kicad_sch, BatteryBusProtection.kicad_sch, BatteryHeater.kicad_sch, BatteryMonitor.kicad_sch, BatteryTemperatureProtection.kicad_sch]
2024-12-21 Silkscreen cleanup
    [BatteryBoard.kicad_pcb, Interfaces.kicad_sch]
2025-01-15 More updates
    [Avionics-BatteryBoard.kicad_pcb, Avionics-BatteryBoard.kicad_sch, Battery.kicad_sch, BatteryBoard.kicad_pcb, BatteryBusDetection.kicad_sch, BatteryBusProtection.kicad_sch, BatteryHeater.kicad_sch, BatteryMonitor.kicad_sch]
2025-01-27 Finalized updates with recommendations and exported files
    [Avionics-BatteryBoard.kicad_pcb, Avionics-BatteryBoard.kicad_sch, Battery.kicad_sch, BatteryBusDetection.kicad_sch, BatteryBusProtection.kicad_sch, BatteryHeater.kicad_sch, BatteryMonitor.kicad_sch, BatteryTemperatureProtection.kicad_sch]
2025-02-04 Added MAX17205 Breakout
    [Avionics-MAX17205-Programmer.kicad_pcb, Avionics-MAX17205-Programmer.kicad_sch]
2025-02-11 uncommitted changes
    [Battery.kicad_sch, BatteryBoardBOM.xlsx, BatteryBusDetection.kicad_sch, BatteryBusProtection.kicad_sch, BatteryHeater.kicad_sch, BatteryMonitor.kicad_sch, BatteryTemperatureProtection.kicad_sch, I2CProtection.kicad_sch]
2025-04-01 Updated board outline and power pinout
    [Avionics-BatteryBoard.kicad_pcb, Interfaces.kicad_sch]
2025-04-01 Fixed programmer board libs
2025-04-01 Increased pad size for power cables
    [Avionics-BatteryBoard.kicad_pcb]
2025-04-19 Updated FPC connector
    [Avionics-BatteryBoard.kicad_pcb, Avionics-BatteryBoard.kicad_sch, Avionics-MAX17205-Programmer.kicad_pcb, Avionics-MAX17205-Programmer.kicad_sch, Battery.kicad_sch, BatteryBusDetection.kicad_sch, BatteryBusProtection.kicad_sch, BatteryHeater.kicad_sch]
2025-06-17 v3.1 Updates
    [Avionics-BatteryBoard.kicad_pcb, Avionics-BatteryBoard.kicad_sch, Battery.kicad_sch, BatteryBoardBOM.xlsx, BatteryBusDetection.kicad_sch, BatteryBusProtection.kicad_sch, BatteryHeater.kicad_sch, BatteryMonitor.kicad_sch]
2025-06-17 Idk some changes
    [Avionics-BatteryBoard.kicad_pcb, Battery.kicad_sch, BatteryBusDetection.kicad_sch, BatteryBusProtection.kicad_sch, BatteryHeater.kicad_sch, BatteryMonitor.kicad_sch, BatteryTemperatureProtection.kicad_sch, I2CProtection.kicad_sch]
2025-06-19 Fixed STEP model thickness
    [Avionics-BatteryBoard.kicad_pcb]
2026-01-21 Local Stash
    [BatteryBusProtection.kicad_sch]
2026-01-21 kicad pull
2026-04-14 v3.2 Updates
    Added 0ohm bypass. Opto-isolated heater enables
    [Avionics-BatteryBoard.kicad_pcb, Avionics-BatteryBoard.kicad_sch, Battery.kicad_sch, BatteryBusDetection.kicad_sch, BatteryBusProtection.kicad_sch, BatteryHeater.kicad_sch, BatteryMonitor.kicad_sch, BatteryTemperatureProtection.kicad_sch]
2026-04-14 Export STEP and BOM
    [Avionics-BatteryBoard.kicad_pcb, Avionics-BatteryBoard.step]
2026-07-21 More v3.2 updates
    [Avionics-BatteryBoard.kicad_pcb, Avionics-BatteryBoard.kicad_sch]
